Heavy-Vehicle-Networking-At-U-Tulsa/CAN-Inverted-Pendulum/TURC - Inverted Pendulum/Connection Color Key 2.png

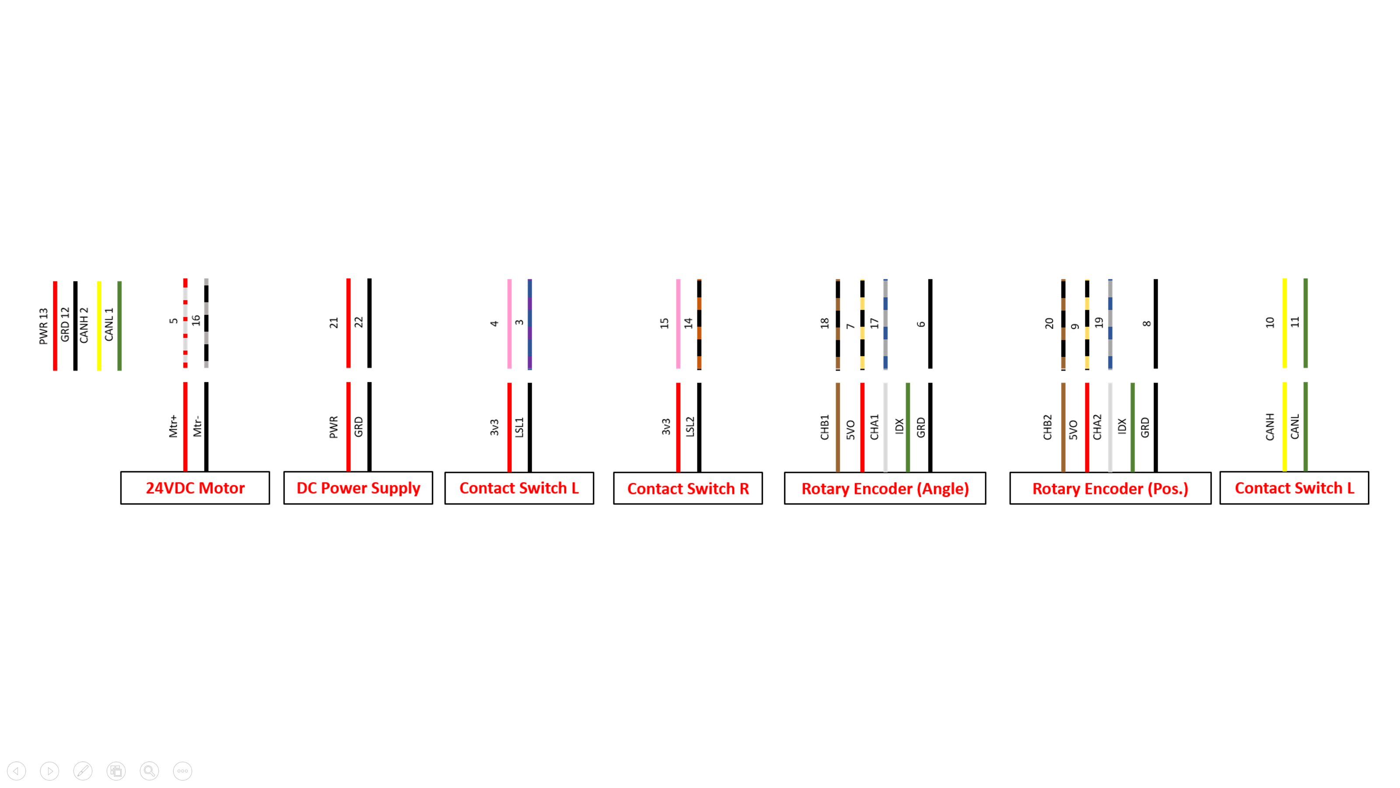
TURC - Inverted Pendulum/Connection Color Key 2.png
