Heavy-Vehicle-Networking-At-U-Tulsa/CAN-Inverted-Pendulum/TURC - Inverted Pendulum/Parts/Encoder Drawing.pdf

## E6 Optical Kit Encoder Drawing

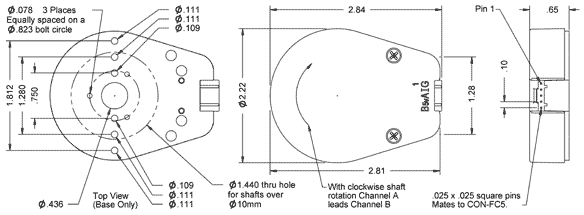
[picture p3: figure]

1400 NE 136th Avenue
Vancouver, Washington 98684, USA

info@usdigital.com
usdigital.com

Local: 360.260.2468
Toll-free: 800.736.0194
