Heavy-Vehicle-Networking-At-U-Tulsa/CAN-Inverted-Pendulum/TURC - Inverted Pendulum/pendulum/Pendulum_Project.pdf

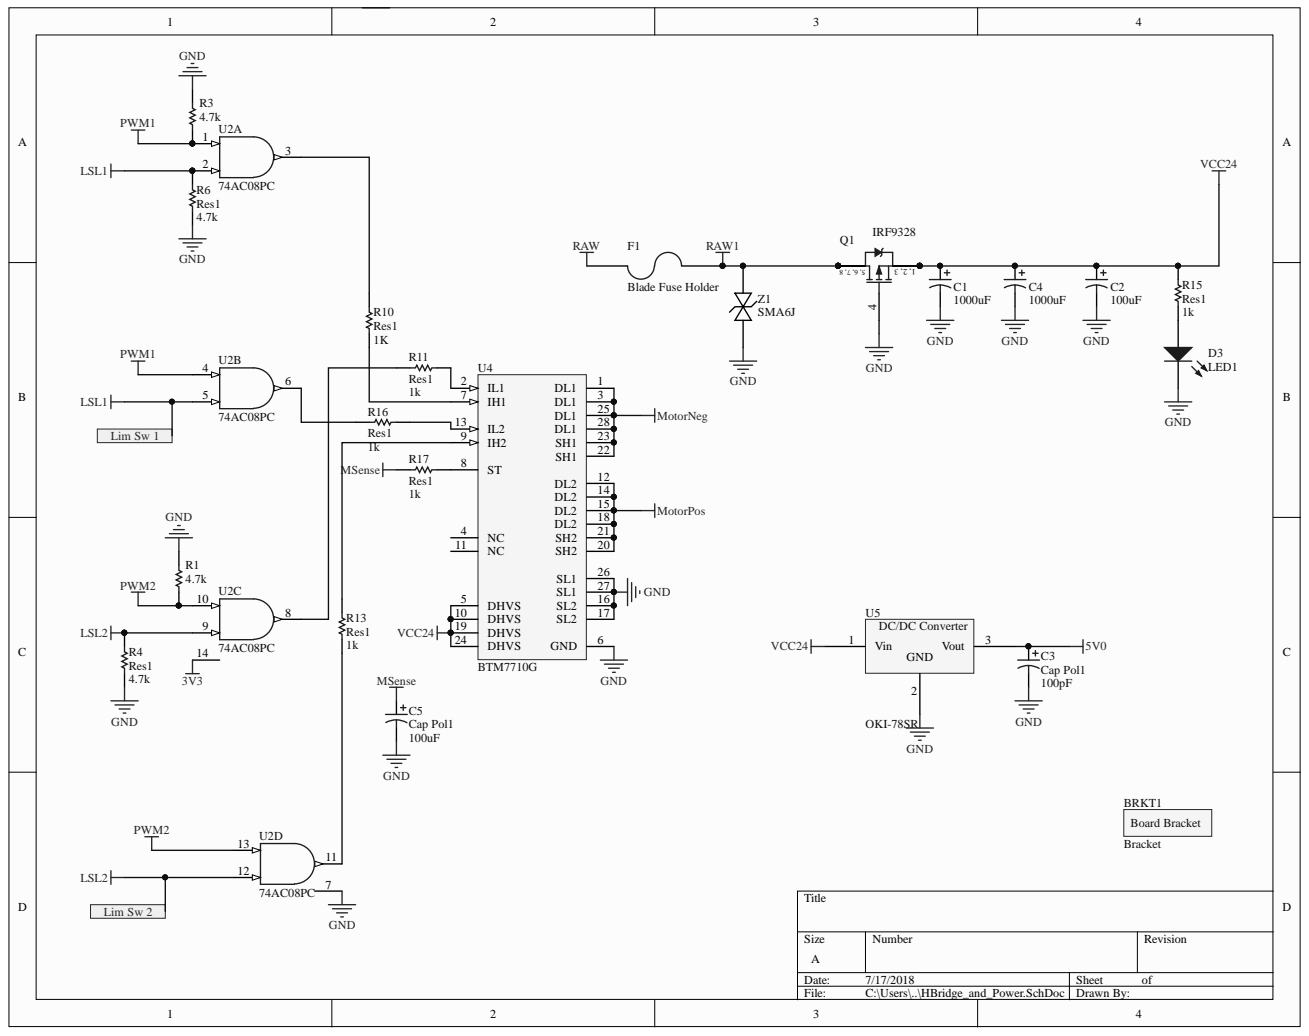
[picture p4: page 1]

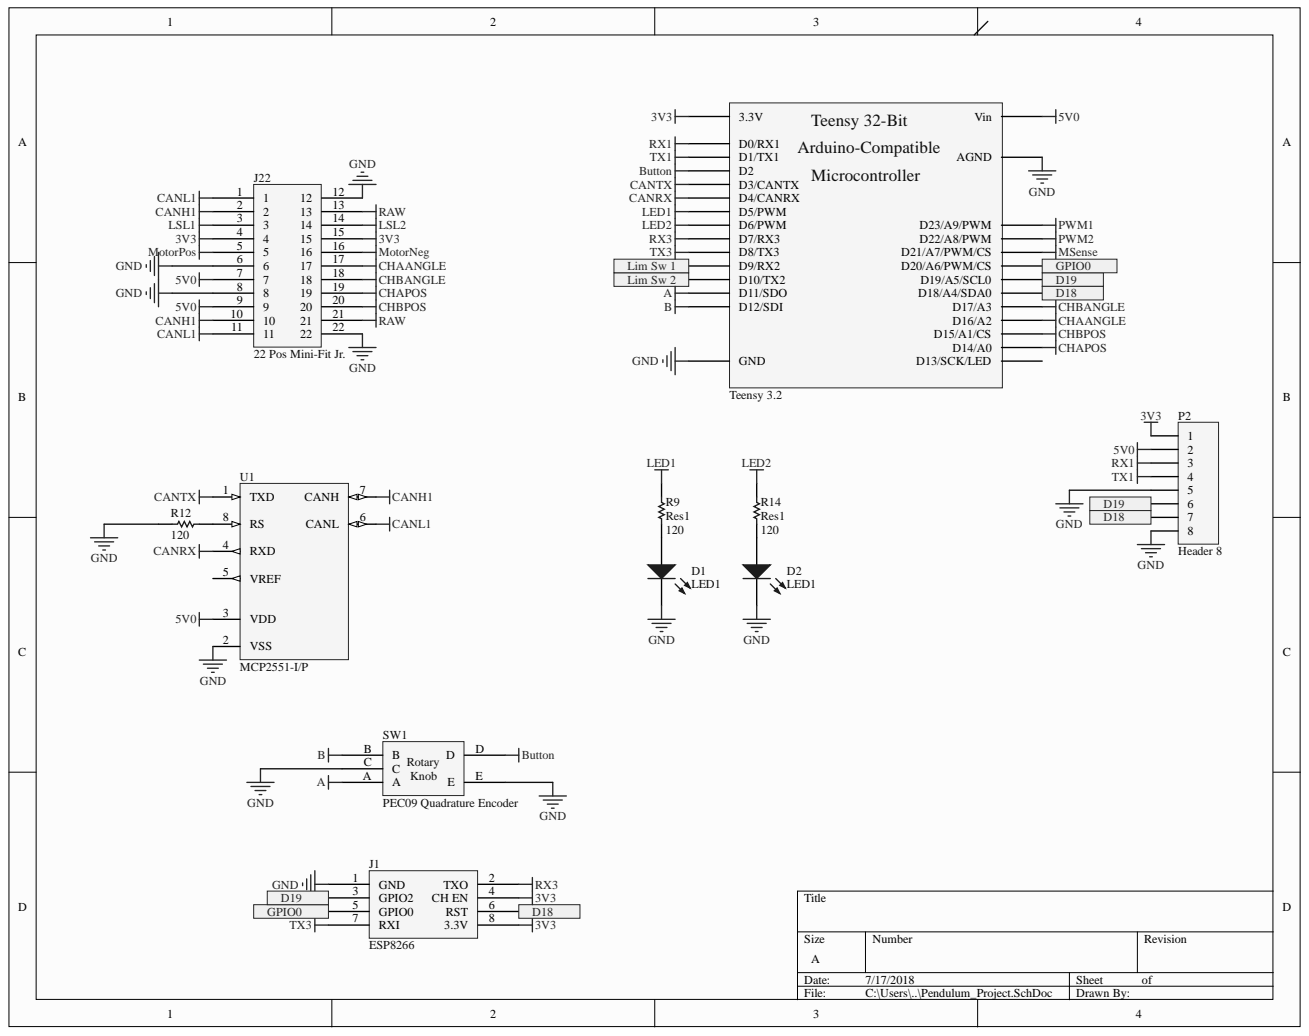
[picture p5: page 2]

22 Pos Mini-Fit Jr.

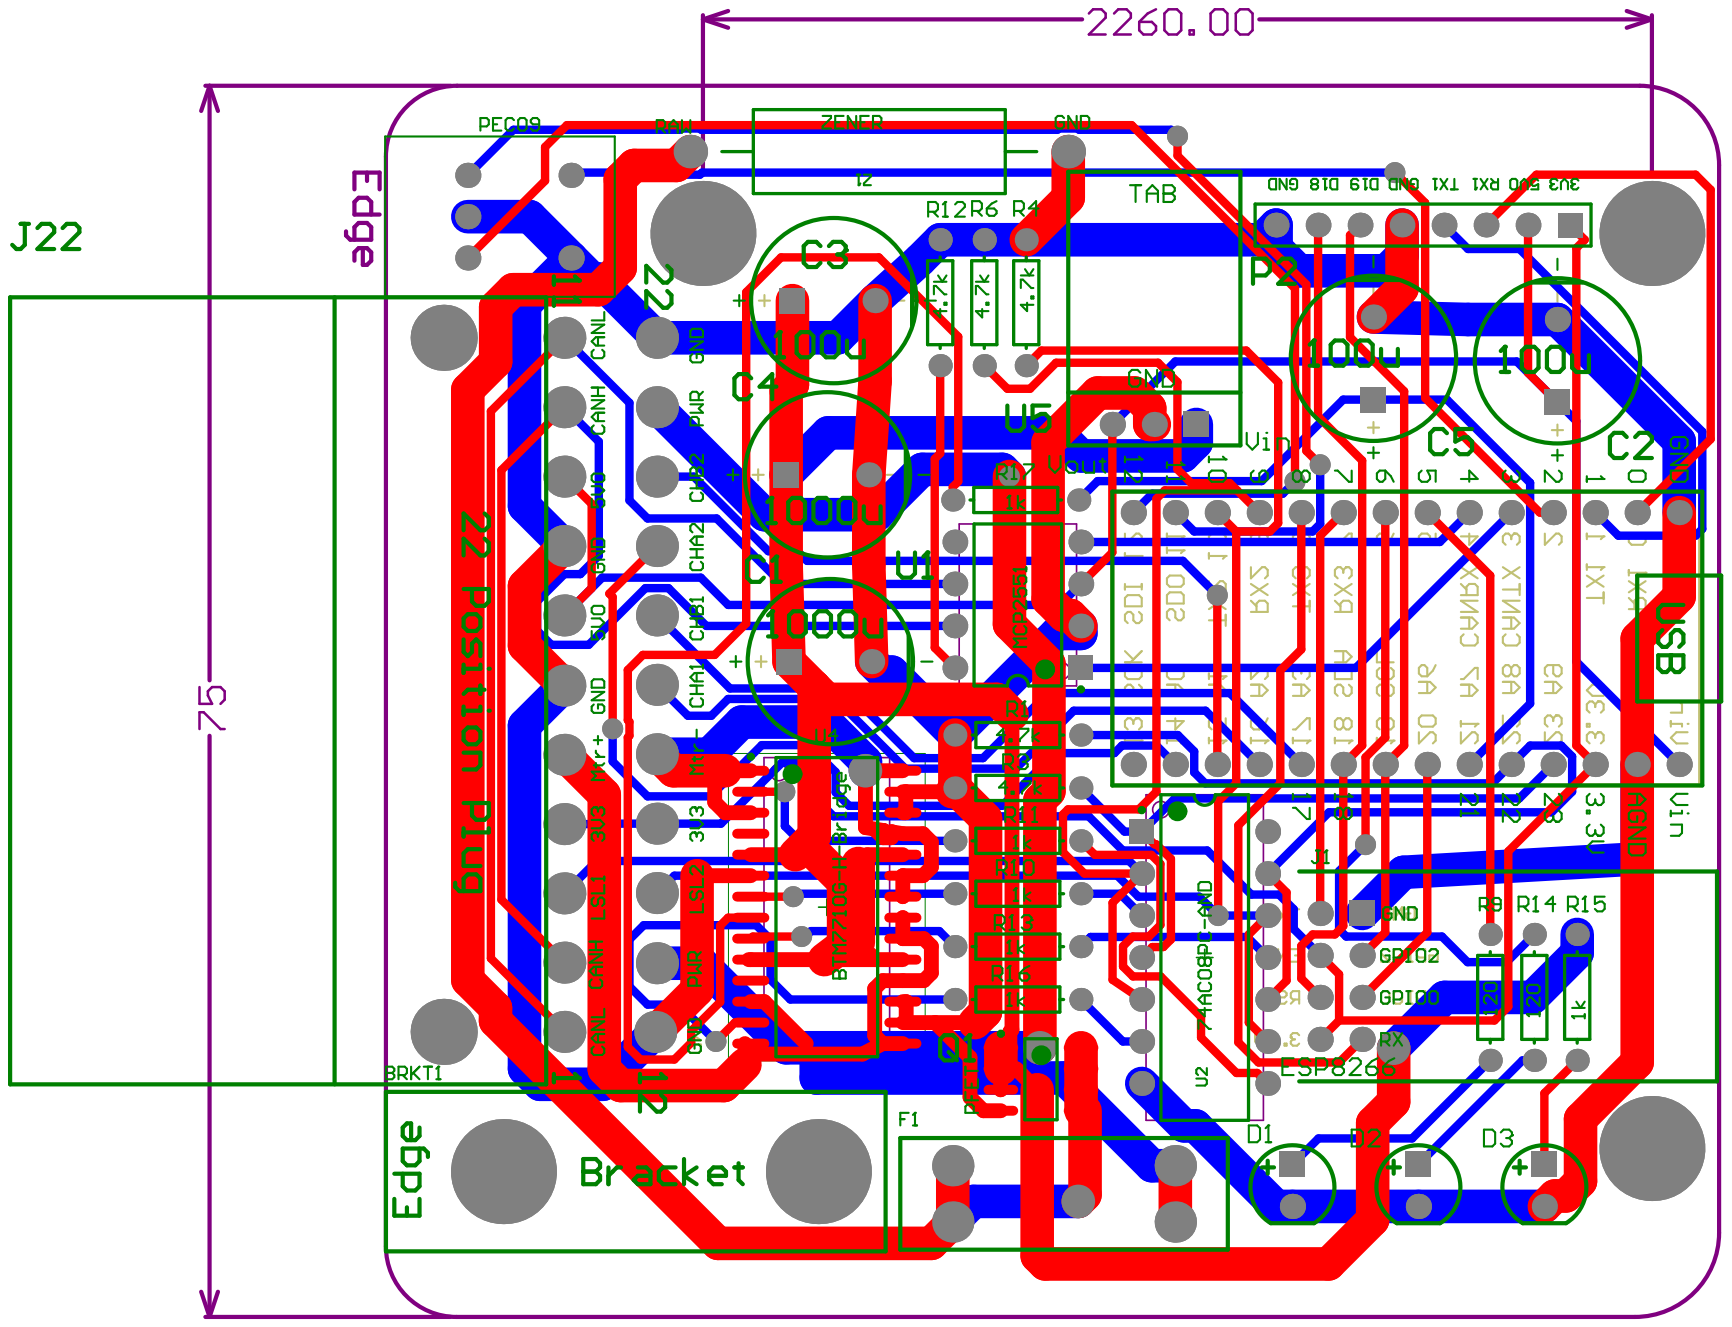
[picture p6: page 3]

# Board S
