Heavy-Vehicle-Networking-At-U-Tulsa/CAN-Inverted-Pendulum/(list of files, drawings)

Other design files:
TURC - Inverted Pendulum/pendulum/HBridge_and_Power.SchDoc
TURC - Inverted Pendulum/pendulum/Pendulum_Project.PcbDoc
TURC - Inverted Pendulum/pendulum/Pendulum_Project.PrjPcb
TURC - Inverted Pendulum/pendulum/Pendulum_Project.SchDoc
